makapuf/bitbox/hardware/palette_b.png

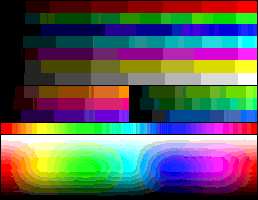
hardware/palette_b.png
