makapuf/bitbox/hardware/pal_micro.png

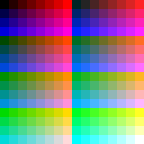
hardware/pal_micro.png
