makapuf/bitbox/README.md

bitbox
======

This is the core project for revision 2 bitbox.

Bitbox is a 32bit open hardware/source DIY console based on a unique chip (a cortex m4 with 1MB flash and 192k RAM).
It has 2 USB devices input, stereo sound output, micro SD card, VGA graphics up to 800x600 @ 32k colors. On the software side, a bootloader, simulators and several games, emulators and libraries.

Also the hardware is included here.

More info on [the development blog](http://bitboxconsole.blogspot.com)



Information can be found on [the project wiki](https://github.com/makapuf/bitbox/wiki)

You can also hop on the mailing list : bitbox-console@googlegroups.com  / https://groups.google.com/forum/#!forum/bitbox-console

Other repos
=========

This repository include the base SDK and some examples. There are other repos on github however: 

 * [A jumper game](https://github.com/makapuf/bitbox-jump)
 * [A GameBoy emulator](https://github.com/makapuf/bitboy)
 * [A ZX Spectrum 48 emulator](https://github.com/makapuf/bitbox-spectrum)
 * [Another game](https://github.com/makapuf/bitbox-polar)
 * [A sound toy / Rhythm box](https://github.com/makapuf/beatblocks)
 * [beam racer - a car game (WIP)](https://github.com/pulkomandy/beamracer_btbx)
 
... and many more ! See [the software index](https://github.com/makapuf/bitbox/wiki/Software-Index) on the wiki
makapuf
