makapuf/bitbox/hardware/README.md

hardware schematics and board licensed under the CC BY SA NC license.
please contact me for commercial uses

makapuf2@gmail.com
