makapuf/bitbox/2nd_boot/8x16_437.png

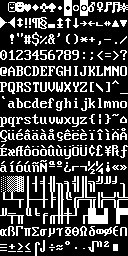
2nd_boot/8x16_437.png
