makapuf/bitbox/examples/blitter_balls/ball/0001.png

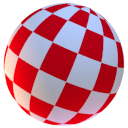
examples/blitter_balls/ball/0001.png
