makapuf/bitbox/examples/blitter_balls/ball/0002.png

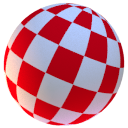
examples/blitter_balls/ball/0002.png
