makapuf/bitbox/examples/blitter_balls/ball/0003.png

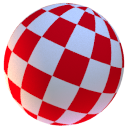
examples/blitter_balls/ball/0003.png
