makapuf/bitbox/examples/blitter_balls/ball/0004.png

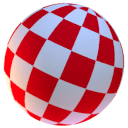
examples/blitter_balls/ball/0004.png
