makapuf/bitbox/examples/blitter_balls/ball/0005.png

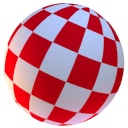
examples/blitter_balls/ball/0005.png
