makapuf/bitbox/examples/blitter_balls/ball/0006.png

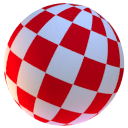
examples/blitter_balls/ball/0006.png
