makapuf/bitbox/examples/blitter_balls/ball/0007.png

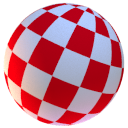
examples/blitter_balls/ball/0007.png
