makapuf/bitbox/examples/blitter_balls/ball/0008.png

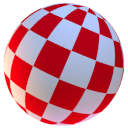
examples/blitter_balls/ball/0008.png
