makapuf/bitbox/examples/sdio/hardcore.png

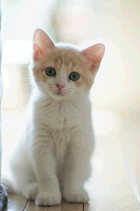
examples/sdio/hardcore.png
