makapuf/bitbox/hardware/micro r15 pcb.png

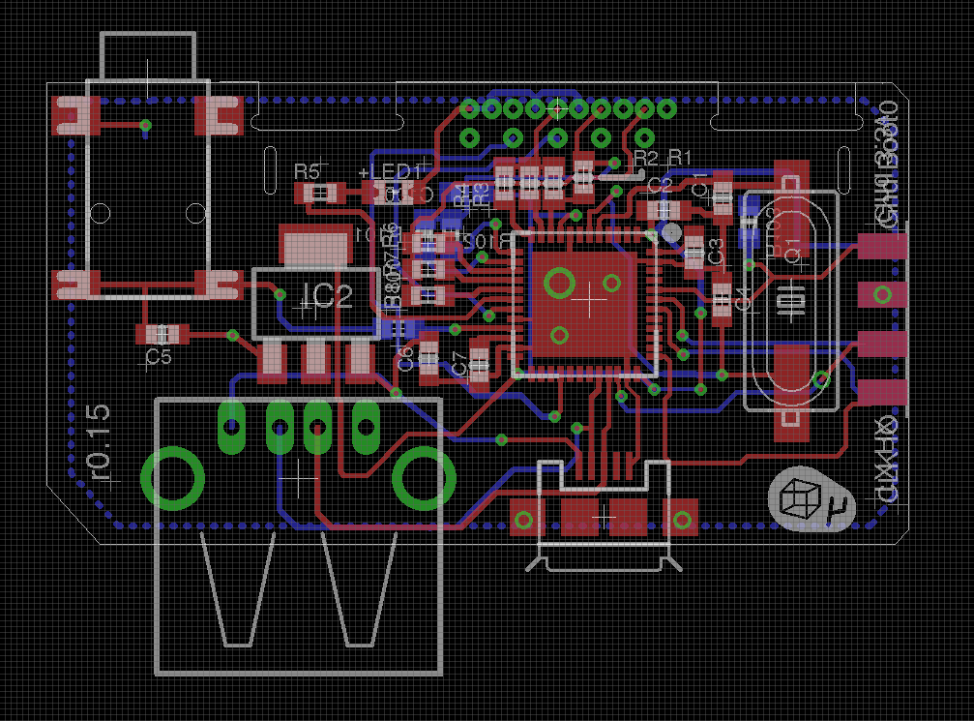
hardware/micro r15 pcb.png
