makapuf/bitbox/hardware/micro r15 sch.png

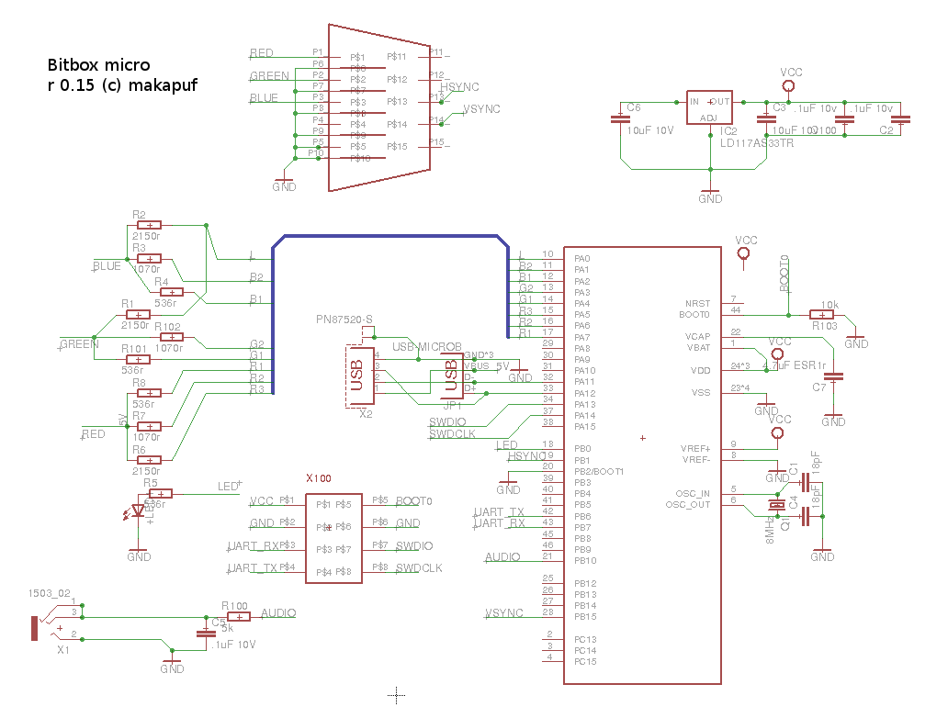
hardware/micro r15 sch.png
