makapuf/bitbox/hardware/palette_analysis.png

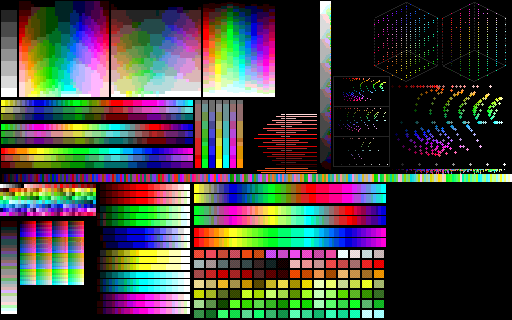
hardware/palette_analysis.png
