makapuf/bitbox/(list of files, cad)

Other CAD files:
examples/blitter_balls/amiga_ball.blend
