makapuf/bitbox/(threads)

Thread 19 (2014-11-23):

make bootloader work with one button

makapuf, 2014-11-23:
short press = next file
long press (after first release) = write it

makapuf, 2017-11-04:
was done long ago

Closed 2017-11-04.

Thread 26 (2015-02-18):

Compile with llvm ?

natir, 2015-02-18:
Hello,

I see on internet we can use llvm for cross-compile to arm-none-eabi.
I'm not sure is important but maybe llvm is better compiler, or we found some other bug with llvm. I thing have many compiler is a good think for the platform.

If you are interest I can work one patch for user can select the compiler.

makapuf, 2015-02-19:
I'm not sure at this point llvm would be a better compiler (in what metrics ? it seems gcc still has an edge for performance for baremetal). It might prove interesting to study however in the future (provided we don't complexify the build scripts for board + emulation ...). maybe trying it on a game would tell if the concept is easy. Please tell if a kernel file is not building right with llvm by example !

andybest, 2016-01-22:
I think LLVM ld still lacks good support for linker scripts, which currently stops it being useful for this sort of thing

makapuf, 2016-03-24:
thanks, will close for now

Closed 2016-03-24.

Thread 34 (2015-06-29):

add support for user options

makapuf, 2015-06-29:
user options in flash would be settable in 2nd bootloader
they will be stored in second page of flash
they can include:
keyboard type (1word)
a flag to check if data has been initialized (1word)
gamepad button mappings, default player name (1word)
maybe game specific data ? should reserve IDs in flash.

pulkomandy, 2015-07-17:
For game specific data it woudl be possible to implement a "cookie jar" system. Some inspiration: http://toshyp.atari.org/en/003007.html

makapuf, 2015-07-17:
well, I did implement a system like this, (lib/eeprom.c/h) but I never used it, too complex.

Couldn't we use a simpler system with a fixed array of u16 values in flash with identifiers set in a header in the main repo lib ?
example of a options.h file :
```
#define OPT_PACMAN_HISCORE 12
#define OPT_BITBOX_KEYBOARD 1 // useful values : 0xffff=EN, 0001 : FR, ..
#define OPT_PULKOTACKER_THEME 5
```

directly reading flash_options[OPT_SYSTEM_KEYBOARD] and set_option(OPT_SYSTEM_KB, 2) to set those ?

Or maybe I'm missing a function of cookie jars ? (we're using a fixed size here anyways)

pulkomandy, 2015-07-17:
In the cookie jar, you can allocate tags for a lot of applications, possibly more than you have bytes in the flash memory. The idea is that users will never run ALL the apps on a bitbox, so they will only have the cookies of applications they already used. And if they run out of space, user can identify each cookie and decide to keep or remove it.

However, maybe we don't have plans for that much apps on the bitbox?

makapuf, 2015-07-17:
well, it was basically the eeprom thing (that+flash wear levelling). I
don't think it will be useful before long :) 4k with u16 data is 2048 slots
! if we use 4 per prog that's 512 games. I think we're set. If a program
needs to store some fat data, just use the SD card !

2015-07-17 14:29 GMT+02:00 Adrien Destugues <notifications@github.com>:

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

makapuf, 2015-07-26:
Well, I think I forgot something: we're not rewriting flash at will, we
need to erase flash before we write it.
So the eeprom.c were made from this need: if you need to rewrite a value,
you need to load the whole sector, erase it, modify it where you want in
RAM and then rewrite it with the new value - which not fast ! So a growing
list of key/value pairs are much faster if you rewrite the same value ten
times (and wears less the flash) - like in a game when you're beating
scores repeatedly, and you can compress it from time to time.

2015-07-17 14:39 GMT+02:00 mak apuf <makapuf2@gmail.com>:

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

Thread 43 (2015-10-06):

fix tiny pixel-glitches in bitbox visual output

lowagner, 2015-10-06:
bitbox output can sometimes look clean (like when waiting for input on bootloader 2), but when activity starts or more computations are run, the output can have some small pixel glitches.

(i also added it to the [Wishlist](https://github.com/makapuf/bitbox/wiki/Wishlist)).

makapuf, 2016-09-28:
from what I can see, this happens because of interrupts having impacts on the access of buses and/or cpu states. I suggest we try outputting sound and maybe also usb during hsyncs and see what happens

pulkomandy, 2016-11-14:
On my setup this is very visible during SDCard access (for example when loading files in the chiptracker). Maybe the priority of interrupts can be tweaked and/or interrupt nesting should be enabled?

Does the SD Card and USB also use DMA or are they done with the CPU? Maybe the DMA unit does not handle well dealing with multiple channels?

makapuf, 2016-11-14:
in fact I guess the contention comes from AHB2 access during interrupts
and/or interrupts. current plans include
- polling interface through line callbacks instead of current interrupts
for sound, usb or SD
- verification of no DMA usage
- usage of sdram2 instead of SDRAM1 for blitting, CCM for sd / usb
...

2016-11-14 22:09 GMT+01:00 Adrien Destugues <notifications@github.com>:

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

lowagner, 2016-12-01:
does this have anything to do with it?
http://cliffle.com/article/2015/06/11/matrix/

lowagner, 2016-12-08:
v0.10 seems to have regressed for me, though i will try to do more testing.  at the very least, i get some black pixel rows in 16, near the center of the screen, in the main game as well as on the menus.  in the old v0.9 sdk, i wouldn't get any black lines in the menu screens, and i would only get the black lines in the main game when lots of sprites occupied the same row.

lowagner, 2016-12-08:
ok, here's the difference between old and new, 0.9 to 0.10, with the black lines:
https://www.youtube.com/watch?v=gFBTXkjD8sI

lowagner, 2016-12-10:
ok, well, things are super strange.  the other bitbox examples are fine, bdash looks good with the new v0.10 sdk.  trying to figure out what's different about 16 compared to others (it does incorporate everything, so io, music, etc. could all be to blame.)  most of the other changes in v0.10 have been usb related:
https://github.com/makapuf/bitbox/compare/v0.9...lowagner:master#files_bucket

i suppose i should raise this as a new issue on bitbox 16 (incompatibility with sdk 0.10 update???), but i'm very puzzled!

Thread 45 (2015-12-22):

new bitbox bootloader doesn't allow usb input???

lowagner, 2015-12-22:
latest bitbox bootloader (made from 2nd_boot directory) appears not to work with input.

at some point, we could also make it so that the 2nd boot loader can't flash itself.  (was trying to do this when i noticed this bug.)

makapuf, 2015-12-22:
It's in fact worse than this, the current usb stack is for whatever reason
broken ! Please stay with / download / checkout an old kernel (pre
bigbang)  to have a good version.
Le 22 déc. 2015 6:15 PM, "Lucas O. Wagner" <notifications@github.com> a
écrit :

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

makapuf, 2015-12-22:
The current status is AFAIK only the second usb works.

lowagner, 2015-12-22:
we probably should have done another bitbox release before the new stuff.
hopefully it will get all worked out soon!

lowagner, 2015-12-28:
i think i've gotten a working premicro branch, with some of my chiptune additions.
https://github.com/lowagner/bitbox/tree/premicro
most things compile and work, though bitbox-polar has its main sprite get its plus/minus/neutral frames messed up.  can't get bitbox-jumper to compile, though.  IIRC, bitbox-raycaster has some weird color issues, as does rapidball, though they are completely playable.

though i'm not sure how to do a pull request to create a new branch on the makapuf/bitbox sdk.

makapuf, 2015-12-30:
Cool ! The polar frames will be easy to solve it's in the makefile. The
rest I will try to fix it. I think we can get this commit and tag it as a
basis for a stable branch and work on a master unstable branch. Can you
tell me the sha1 of the branching point ? Thanks !
Le 28 déc. 2015 6:35 AM, "Lucas O. Wagner" <notifications@github.com> a
écrit :

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

lowagner, 2015-12-31:
here's the spot where i went back to (i think):
2c85801f04d440f1975ceeab20541637513e4fa4

if you like, you can create a branch ("premicro" or whatever you like) and rebase back to that, and i can do a pull request.

makapuf, 2016-01-01:
ok I released a v0.8 branch (as a stable kernel version pre-micro and 15khz)
How can we process from there ? Can you rebase from this and submit a pull request to this 0.8 branch ?

Closed 2016-01-10.

Thread 59 (2016-03-07):

second usb input not always working

lowagner, 2016-03-07:
your latest commit (shuffling init code) made me wonder:  if NO_USB is not defined, is it possible to wait a second or two to try and init the second usb?  i'm still not getting very consistent 2nd player in bbgunner.  i've found i can get better chances (though not perfect) if i disconnect player one, connect player two, start the bitbox, then plug in player 1.  snake gets it pretty consistently by keeping both in.

i've tried giving the bitbox a bit more power, and that doesn't seem to help.

also, for debugging and testing other usb devices, would it be possible to have test_usb have a super low level "what i'm seeing from the usb", so we can maybe debug and add other usb devices?  (i.e., before we interpret any button press as "left" or "A", just get the usb data chunks...)  if this is possible, i can submit a new issue for it...

makapuf, 2016-04-22:
USB really needs some love, I feel it's soo unnecessarily complex... for the simple use cases we have.
It would be nice starting either to look at another usb stack or simplifying it much (to be able to debug it !) but it's quite hairy and I don't know where to start .. maybe we need to do it piecewise. and, yes, a datadump would be a good starting point.

pulkomandy, 2016-04-22:
I usually find http://www.beyondlogic.org/usbnutshell/usb1.shtml quite useful on USB matters. Lots of reading, however.

makapuf, 2016-04-22:
sure, it's a great resource which I used for an intro on USB !
It also seems the usb driver has been updated, that would be a start.

2016-04-22 11:12 GMT+02:00 Adrien Destugues <notifications@github.com>:

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

lowagner, 2016-12-12:
still would love to understand why we get plug-and-unplug OK for the first player, but it doesn't really work for player two.  i like making multiplayer games for the bitbox, but it's a pain to get it setup so player 2 works!  (lots of trial and error...)

makapuf, 2016-12-12:
Yes this need some more work.

Le 13 déc. 2016 00:40, "Lucas O. Wagner" <notifications@github.com> a
écrit :

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

lowagner, 2017-07-20:
as a note, 2nd player works even less well with commit:
513c4bba001212931d3f6c4a8b1e3bfa087dd1eb

this branch reverts that and gets back to about where we were (>50% chance of 2nd player working):
https://github.com/lowagner/bitbox/tree/test

makapuf, 2017-07-26:
Hi, I tried reverting this commit and have not had much success, ie the success rate is about the same (50%).
Do you confirm it's the case with your device ?
Also, I updated the test usb to give more details , can you try it and give me the results when working or not ?
also, can you try plugging a mouse by example on the second por with test usb and tell me the results also ?
thanks

lowagner, 2017-07-26:
i seem to get much worse success than 50% with the above commit 513c4bb, and around 50% without it (when commit 513c4bb is reverted); but i will report back soon with the results from test_usb.

makapuf, 2017-09-14:
can you send me your binaries ? Maybe there is a mismatch in binary code ?

2017-07-26 15:49 GMT+02:00 Lucas O. Wagner <notifications@github.com>:

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

Thread 63 (2016-05-24):

change graph_frame to graph_line

makapuf, 2016-05-24:
The idea of this would be to replace the graph_frame callback, which happen in a line callback (so you have only one line worth of time) to calls to graph_line even during the vblank period.

The way to distinguish would be by checking that vga_line is > VGA_V_PIXELS, but this would allow spreading synchronous processing to several lines and simplify the API (one less callback). But this will be incompatible so let's wait for a new branch.

makapuf, 2016-10-01:
Done in branch 0.2

This will be done using a graph_vsync since there is no case where  vsync and display functions wont be completely different.

Closed 2016-10-01.

Thread 66 (2016-06-21):

replace graph_frame with graph_lines

makapuf, 2016-06-21:
have only one graph_line callback instead of two
It would allow better vsync lines usage since we would use all vsync lines.
This will be incompatible with current kernels, just check vga_line is < VGA_PIXEL_H for normal operation.

makapuf, 2016-07-26:
duplicate of #63

Closed 2016-07-26.

Thread 67 (2016-07-24):

need some defines for NO_VGA

lowagner, 2016-07-24:
need to add some define checking to compile with NO_VGA option, at least in these locations:

```
diff --git a/lib/emulator.c b/lib/emulator.c
index df6aaad..9b857fe 100644
--- a/lib/emulator.c
+++ b/lib/emulator.c
@@ -99,6 +99,7 @@ uint32_t time_left(void)
 }

+#ifndef NO_VGA
 extern uint16_t palette_flash[256];

 void __attribute__ ((weak, optimize("-O3"))) graph_line(void)
@@ -113,6 +114,7 @@ void __attribute__ ((weak, optimize("-O3"))) graph_line(void)
             draw_buffer[i] = palette_flash[drawbuf8[i]];
     }
 }
+#endif

 /* naive pixel conversion
 from 16bit bitbox pixel 0RRRRRGGGGGBBBBB
@@ -673,10 +675,12 @@ int main ( int argc, char** argv )
         // update time
         vga_frame++;

+        #ifndef NO_VGA
         if (scale==1)
             refresh_screen(screen);
         else
             refresh_screen2x(screen);
+        #endif

         SDL_Delay(time_left());
         next_time += slow ? TICK_INTERVAL*10:TICK_INTERVAL;
```

oh, and bitbox_main.c also requires it, since vga_frame isn't defined.
```
▸   ▸   #ifndef NO_VGA
▸   ▸   int oframe=vga_frame;
▸   ▸   while (oframe==vga_frame);
▸   ▸   #endif
```

lowagner, 2016-07-24:
here's an example project:
https://github.com/lowagner/bitbox-modes/tree/master/noisebox

lowagner, 2016-07-26:
fixed with a26ca5c6f0f45bc152ca86cad36c9373d9e4d15a

Closed 2016-07-26.

Thread 71 (2016-09-28):

refactor libraries

makapuf, 2016-09-28:
libraries should go in their own directories and maybe not in kernel.
including libs in projects would imply adding them in makefile and not declaring any makefile magick.
Also remove old chiptune code.
would then allow more libs to be distributed in main project and simplify kernel directory

makapuf, 2016-09-28:
also maybe let events be a simple library

lowagner, 2016-09-28:
just make sure to put out a metastable release before we do anything crazy...

makapuf, 2016-09-29:
sure, (well the idea is just to change a few paths and adapt slightly APIs, but the 0.1 branch will be "properly" maintained - as in, not completely forgotten)

I just now refrain from integrating interesting libs because of the current big lib directory mess (*ahem* tile16 *ahem*). splitting into useful libs + base kernel can be useful.

Also, versioning APIs and simplifying build process can be useful. not all needs to be automated by example.

Milestone 0.2 ideas welcomed ! just add issues.

makapuf, 2016-09-29:
the smaller kernel could allow inclusion in projects, *optionally* allowing it to be released as part of the game for easier compatibility breaking changes (by example using submodules).

makapuf, 2016-09-29:
namely, move :

- blitter.c, blitter.h, blitter_btc.c, blitter_sprites.c, blitter_tmap.c
- chiptune.c, chiptune.h, chiptune_engine.c, chiptune_engine.h, chiptune_player.c, chiptune_player.h
- eeprom.c, eeprom.h
- evt_queue.c /.h (in bitbox)
- sampler.c, sampler.h
- simple.c, simple.h, simple_micro.c

lowagner, 2016-09-29:
sounds good!  what were you thinking of integrating from tile 16?

so you're thinking of having separate directories for each "category" of the current libs?

makapuf, 2016-09-29:
well tile16 as a general tile/sprite engine could be useful !
I propose having one big lib dir for now, with preferably one .c and one .h per lib (with dc in .h and - maybe even one .h only) + maybe a script in /scripts (renamed /bin ?)

makapuf, 2016-09-29:
also planning to integrate misc other libs from myself : .bmp / .tar loader, ..

makapuf, 2016-10-01:
almost done for the refactoring in branch 0.2 , also modified a few libs (not much for now but work is still ongoing).

makapuf, 2016-10-06:
going further, I guess it would be nice to have a subdir of /lib for each library with
- .h/.c lib files
- test.c + Makefile of the test
- helper python scripts
- any other support files

by example :
/lib/blitter/blitter.h and lib/blitter/example.c, /lib/blitter/tmx.py
/lib/textmode/font2c.py /lib/textmode/font8x8.png, /lib/textmode/textmode.h
/lib/chip/chip.h, /lib/chip/song2c.py

using them with
#include "textmode/textmode.h"
...

any thoughts ?

lowagner, 2016-10-06:
it might help to organize things.  and when a new person comes in, they can understand what different scripts are for (at least within a category) -- which would be helpful.

makapuf, 2016-10-11:
mostly done in branch 0.2

Closed 2016-10-11.

Thread 72 (2016-10-04):

support gravis/snes controller

makapuf, 2016-10-04:
the support of those controllers could be made using a library,
- writing to the standard interface for controllers gamepad_buttons on gamepad 0
- we would need a small buffer processed at hsync time.  115200bps == 14400 Bps so we could just check every line that we need to send/receive something (avoiding interrupts). but that would need support from the kernel instead of using a library.

this could use a general async file interface with 0 as fd for uart
the async interface for read/writes could be:

    int _write (int fd, const char *ptr, int len) : async write len bytes. write len=0 to cancel writes. returns 0 ?
    int _write_busy (int fd); // return bytes left to send.

    int _read (int fd, char *ptr, int len) : async read up to len bytes to buffer. returns 0 ? error ?
    int _read_busy (int fd); // return bytes left to read

we could thus interface with a mini printf !

pulkomandy, 2016-11-14:
Example for Gravis protocol implementation: https://github.com/pulkomandy/stm32f3/blob/master/src/main.c#L80

makapuf, 2016-11-15:
I see you're using interrupts, which I'd like to avoid , so would it be possible to poll on the GPIO ? What is the data rate ?
Do you think we could use SPI to deserialize data ?

makapuf, 2016-11-15:
also, I hestitate to use as a makefile variable -DGRAVIS , an explicit lib call or a dynamic (but how would we use different hardware ?)

pulkomandy, 2016-11-15:
I think you can look at the previous commit for a polling version.
My notes about the protocol: http://pulkomandy.tk/_/_Electronique/_Gravis%20Interface%20Protocol

The data rate is about 20 to 25KHz on my controllers. SPI is possible except there is a continuous clock stream and no "chip select" so it won't detect the start and end of frames. You will need to look for the known start pattern (5 consecutive 1 bits) to resynchronize with the bitstream coming from SPI. Once synchronized, the stream has frames of 24bits so you can decode it with a fixed shift.

pulkomandy, 2016-11-15:
(and for the SNES: IIRC, it is up to us to generate the clock. This means we can be SPI master, whereas for Gravis, the controller generates the clock and we are SPI slave).

makapuf, 2016-11-15:
Yes the bitbox1 used snes, it's delightfully easy compared to usb

Le 15 nov. 2016 14:17, "Adrien Destugues" <notifications@github.com> a
écrit :

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

Thread 76 (2016-10-22):

master should become v0.10 branch

lowagner, 2016-10-22:
master should track along with development, just for ease of developing...

i suppose that means renaming the current master to v0.1, and renaming v0.2 to master.  (then splitting v0.2 off when a new version arises?)

(should v0.8 then be renamed to v0.08?)

thoughts?

makapuf, 2016-10-22:
good for me, but I didn't want master to be unusable. it's becoming to be ok, I just want to try working on usb. So it's a branch until I fix/validate 8bit behaviour/ basic libs.
Maybe we can have v0.8 still being v0.8, current being v0.9 and current v0.2 becoming v0.10 (would avoid renaming past things)

lowagner, 2016-10-22:
ok, fine by me.  i'll see how to unmerge your commit on greeble until the new kernel becomes useable...

makapuf, 2016-10-22:
On 16bit kernel it's definitely usable.

makapuf, 2016-10-22:
0.2 renamed to v0.10

makapuf, 2016-10-25:
If you're on 16bits it's OK.

Le 22 oct. 2016 19:14, "Lucas O. Wagner" <notifications@github.com> a
écrit :

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

lowagner, 2016-10-25:
do you mean the bitbox macro (as opposed to micro)?  16bit color i guess...

still would like 0.10 to become "master", so that master tracks along with development (and eventually 0.10 splits off when we complete all milestones for 0.10)...

i think you could do that by creating the 0.9 branch from master, then merging your 0.10 into master (though there may be some conflicts), and later we can split off a 0.10 when we start going beyond 0.10...

makapuf, 2016-10-27:
sure, I just would like to finalize things a bit in the next few days.
wouldn't using submodule for games be a good idea to have a fixed kernel version ?

pulkomandy, 2016-10-27:
Yes, games can import a specific version of the kernel as a submodule. I think this makes sense: any kernel update needs to be tested with each game, and when things are ok, it can be updated.

makapuf, 2016-10-30:
only issue is that the current kernel has many libraries (ok) and examples, bootloaders, scripts  ...
Should we really duplicate all of this in a /kernel subdirectory ?

lowagner, 2016-12-05:
sorry to bother, how is the micro lib coming along?  will we be able to set master->0.9, and merge 0.10 -> master soon?  or were you going to split the kernel off into its own repository (to become a submodule in other projects), and just keep examples in this repository?

makapuf, 2016-12-05:
Well, I think the interface changes are almost over.
I'm thinking about a bit more but they can be pushed to a v.11, it's not a big deal.

makapuf, 2016-12-05:
in the meantime, v0.10 is becoming default branch now.

makapuf, 2016-12-07:
Closed with commit a62946dd

pulkomandy, 2016-12-07:
It would be nice to have a "release" of 0.9 for future reference?

makapuf, 2016-12-07:
Sure, what kind of release are you thinking about ?

Closed 2016-12-07.

Thread 79 (2016-11-14):

emulate second gamepad on keyboard

makapuf, 2016-11-14:

makapuf, 2016-11-14:
using numpad + home/pgup .. ?

makapuf, 2016-12-12:
proposal : WASD (QWERTY) / ZQSD (AZERTY) + IOKL (buttons) + enter/space (pl1) + Arrows/keypad keys  (pl2) ? please vote !

pulkomandy, 2016-12-12:
My bitbox keyboard does not have a keypad. Maybe it would be better to fit everything on letters then?

makapuf, 2016-12-12:
Ah ok. Maybe we can have compile (or even run-) time keyboard switches ?
Sometime the directional keys must be on the left like a gamepad (eg mario watch )

Thread 80 (2016-12-07):

move over draw_buffer in relation to LineBuffers

lowagner, 2016-12-07:
in vga_bitbox.c, didn't we think to do something like this?

uint16_t *display_buffer = LineBuffer1 + 112; // will be sent to display
uint16_t *draw_buffer = LineBuffer2 + 112; // will be drawn (bg already drawn)

(112 = (1024 - 800)/2, with 800 being max horizontal resolution, so we get a big chunk on the left (112 pixels) and right (112 as well) that we can draw to without segfaults.)

not sure how to do this for the micro, or if that messes things up.

makapuf, 2016-12-07:
it's not that simple in fact, you need the DMA to start at a 4kB boundary in certain circumstances, so LineBuffer1+112 must be aligned at a 4kB boundary

lowagner, 2016-12-07:
ok, glad i didn't try to submit a PR with that then :).  not sure how it all works down on the lowest level, but will it be possible to do something like this?  i'd be happy with even 16 pixels on either side, 32 should be definitely enough -- i don't know if that helps to keep it simple.  112 doesn't have to be a thing...

makapuf, 2016-12-07:
please add a defect to remember doing it someday ! I guess it can be done playing with linker scripts.

makapuf, 2016-12-13:
See current investigations on how to do it - definitely not simple.
http://stackoverflow.com/questions/41122880/align-a-variable-in-memory-with-offset-from-power-of-two-in-memory

lowagner, 2016-12-13:
definitely looks tricky!  though i'd like 32 bytes (= 16 bitbox pixels) if possible...  sorry to be picky...

Thread 85 (2017-05-16):

misc. micro bugs

makapuf, 2017-05-16:
- it should be possible to power the micro from a PC. Currently the usb lines
- there should be a user button on micro
- maybe a power led ?
- there should definitely be a reset button on micro
- it should be possible to power the micro from a 5v external . currently it's only possible with a 3.3v regulated.

Thread 91 (2018-06-05):

A compatible sdk is missing, I can't figure out how to build the project.

Jubatian, 2018-06-05:
As of now a compatible SDK seems to be missing, the sdk subrepo link points to a nonexisting commit. The build generates several errors related to interface incompatibilities with the current sdk. I tried to check out earlier commits from the SDK (mostly those around 4 months before which align with the last commit of this repo), but neither seems to work, there are various incompatibilities.

How this should be built proper?

makapuf, 2018-06-07:
should be fixed now with commit 65802fae90a38297c6e9464e835bf1238e5a9bb8

Jubatian, 2018-06-08:
Thanks, from a clean clone, it builds now!

Closed 2018-06-07.

Thread 92 (2018-06-05):

What type of SD cards are supported?

Jubatian, 2018-06-05:
I was trying to run a game on the hardware. First (without much reading, I admit) I copied a .bin file onto a micro-SD I had lying around, plugged it in the Bitbox, and using an USB keyboard I assume I started it (the file's name showed in the selector, I tapped Enter). Then the screen went blank, my monitor wouldn't sync any more (the game is bitbox-jump by the way).

Then (as I couldn't get to have an image at all) I read how to reset it into the bootloader, and that the card should be containing a second boot binary. I copied that off from this repo (that builds for me) onto the card, and with that, I could successfully return to the second bootloader. However it is different, it wouldn't list any files on the card, even though I still had the game on it.

The card is an SDSC (256Mbytes), it was formatted FAT-16. After reading the Wiki, and seeing FAT-32 mentioned in it, I reformatted it, but still, the game's file wouldn't display (even though the second boot loader starts). I presently don't have any SDHC Micro cards, so I can't try what would happen with one.

For me it seems like that this second boot, compiled from the repo, doesn't support SDSC cards (or at least that seems to be the most plausible explanation to my experience), and maybe neither FAT-16, while probably the first boot does (as it apparently could load the second boot from the card).

Could this be? (The card is certainly an SDSC, I tested its protocol in another project)

Jubatian, 2018-06-08:
I confirmed this now. The 1st bootloader certainly can use my SD cards, I compiled a smaller example program into RAM (LINKER_RAM = 1 in the Makefile), and naming it 2nd_boot.bin, it loads as a 2nd bootloader proper. So I can actually mess around with the box this way! (so the 1st bootloader what I have on the BitBox apparently can use my cards) It is a rev.2.5 board.

pulkomandy, 2018-06-08:
On Fri, Jun 08, 2018 at 03:59:38PM +0000, Sandor Zsuga wrote:
> I confirmed this now. The 1st bootloader certainly can use my SD cards, I compiled a smaller example program into RAM (LINKER_RAM = 1 in the Makefile), and naming it 2nd_boot.bin, it loads as a 2nd bootloader proper. So I can actually mess around with the box this way! (so the 1st bootloader what I have on the BitBox apparently can use my cards) It is a rev.2.5 board.

I think I have a similar problem witn 2nd_boot failing to show any
files. But I'm not sure which version of it I'm using currently.

makapuf, 2018-06-08:
Hem. It seems 2nd boot needs definitely needs some love.

Jubatian, 2018-06-12:
I did some experiments on the 2nd bootloader. As far as I could track, the program dies in an infinite loop within game_init(), there within f_mount(), and there within find_volume(). That latter was too big for me for now to figure out (it is in sdk/kernel/fatfs/ff.c).

makapuf, 2018-06-13:
Fatfs is an independent library I used - it's used everywhere and I guess it runs much better than my own code, being gameinit or the fatfs to lower layers adapter.

Jubatian, 2018-06-13:
"or the fatfs to lower layer adapter" - I am also thinking that the most possible, however the way I attempted to debug it would be necessary to go through the Fatfs library until pinpointing an interface routine. I simply comment out code and look at the results, it is quite simple: if the bouncy smiley is there, then game_init() passes, if not, then it doesn't. Very tedious as for every attempt it is necessary to check it on the micro (and I have only an SD reader, not Micro-SD, and only a single monitor, so that's a lots of plugging in & out for a single test).

Jubatian, 2018-06-14:
I tracked the execution path further, finding this:

game_init() -> ff.c/f_mount() -> find_volume() -> diskio.c/disk_initialize() -> stm32f4_discovery_sdio_sd.c/SD_Init() -> SD_EnableWideBusOperation() -> SDEnWideBus(ENABLE) -> FindSCR()

There it gets stuck in the loop starting as "while(!(SDIO->STA & (...".

I have absolutely zero experience with ARM so far or these libraries, so I am passing from this. I am planning to experiment with small stuff anyway, for that, the first boot for me is OK for now.

Thread 93 (2020-05-25):

Finding the firmware files

heshananupama, 2020-05-25:
Do you have prebuilt firmware files. I tried to build the examples using examples but it end up in number of errors, I would only need the firmwares and if there are already built firmware that would be great. Thanks

pulkomandy, 2020-05-26:
SDL is not needed for the bitbox firmware. You can run 'make' in the 1st-boot folder to build the stage 1 bootloader. You can also use 'make stlink' to flash it to the bitbox using an STLink. For the other projects (2nd stage loader and examples) you can use 'make bitbox', and 'make dfu' to flash them over USB to the bitbox (much easier than putting them on an SD card to load them).

The SDL emulator currently needs SDL 1.2, which is  deprecated. They should be migrated to SDL2.

makapuf, 2020-05-27:
thanks Adrien,
indeed the version of SDL is quite dated.
I created a new branch with SDL2, but I did not port yet the main repo to it
It's a bit slow on my VM now, I'll check if it can be made faster.
In any case, it seems to work (although I diodn't test it on mac or haiku
:( )

I'ml try to make some firmware available

Le mar. 26 mai 2020 à 11:12, Adrien Destugues <notifications@github.com> a
écrit :

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
