makapuf/bitbox/hardware/microXusb401_r15.brd

## EAGLE design hardware/microXusb401_r15.brd (2016-02-25)

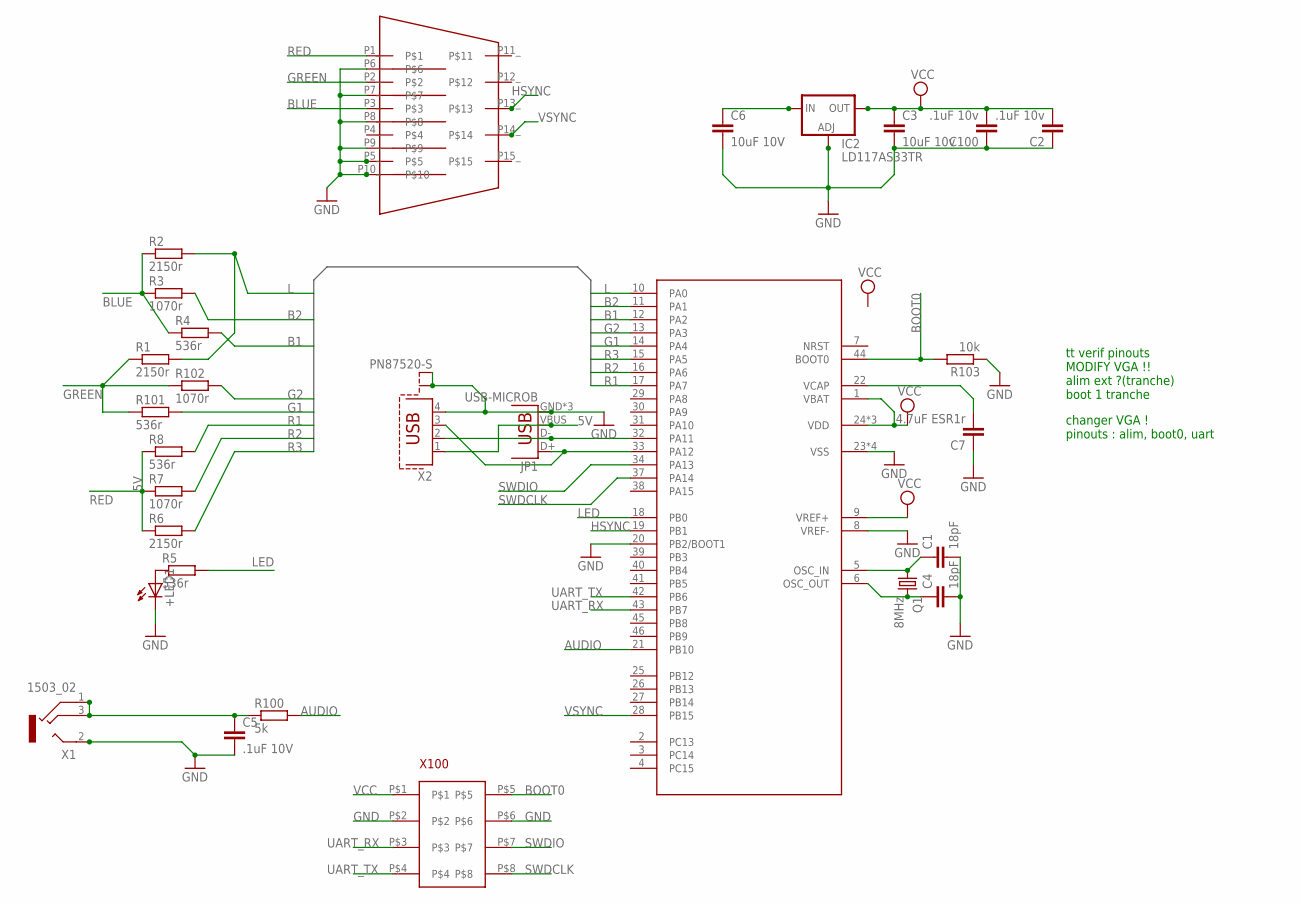
[picture p16: schematic microXusb401_r15.sch]

Parts:
+LED1: LEDCHIPLED_0805; CHIPLED_0805
C1, C4: 18pF; C1608
C2, C100: .1uF 10v; C1608
C3: 10uF 10v; C1608
C5: .1uF 10V; C1608
C6: 10uF 10V; C1608
C7: 4.7uF ESR1r; C1608
CON1: VGA_GTK_USLIM; VGA_SLIM3
IC1: STM32F401CCUQFN48_B; QFN-48
IC2: LD117AS33TR; SOT223
JP1: USB-MICROB
Q1: 8MHz; SM49
R1, R2, R6: 2150r; R0603
R3, R7, R102: 1070r; R0603
R4, R5, R8, R101: 536r; R0603
R100: 5k; R0603
R103: 10k; R0603
X1: 1503_02
X2: PN87520-S
X100: HEADER_BORDER_4X2

Connections:
5V: C6.1, IC2.3 (IN), JP1.VBUS, X2.1
AUDIO: IC1.21 (PB10), R100.2
B1: IC1.12 (PA2), R4.2
B2: IC1.11 (PA1), R3.2
BLUE: CON1.P3_, R2.1, R3.1, R4.1
BOOT0: IC1.44 (BOOT0), R103.2, X100.P$5
G1: IC1.14 (PA4), R101.2
G2: IC1.13 (PA3), R102.2
GND: +LED1.C, C1.2, C2.1, C3.2, C4.2, C5.2, C6.2, C7.1, C100.1, CON1.P5_, CON1.P6_, CON1.P7_, CON1.P8_, CON1.P9_, CON1.P10_, IC1.8 (VREF-), IC1.20 (PB2/BOOT1), IC1.23 (VSS), IC1.35 (VSS), IC1.47 (VSS), IC1.EXP (VSS), IC2.1 (ADJ), JP1.GND, JP1.MT1 (GND), JP1.MT2 (GND), R103.1, X1.2, X2.4, X2.S1, X2.S2, X100.P$2, X100.P$6
GREEN: CON1.P2_, R1.1, R101.1, R102.1
HSYNC: CON1.P13_, IC1.19 (PB1)
L: IC1.10 (PA0), R1.2, R2.2
LED: IC1.18 (PB0), R5.2
unnamed: IC1.33 (PA12), JP1.D+, X2.3
unnamed: IC1.32 (PA11), JP1.D-, X2.2
unnamed: C7.2, IC1.22 (VCAP)
unnamed: C5.1, R100.1, X1.1, X1.3
unnamed: +LED1.A, R5.1
unnamed: C1.1, IC1.5 (OSC_IN), Q1.1
unnamed: C4.1, IC1.6 (OSC_OUT), Q1.2
R1: IC1.17 (PA7), R8.2
R2: IC1.16 (PA6), R7.2
R3: IC1.15 (PA5), R6.2
RED: CON1.P1_, R6.1, R7.1, R8.1
SWDCLK: IC1.37 (PA14), X100.P$8
SWDIO: IC1.34 (PA13), X100.P$7
UART_RX: IC1.43 (PB7), X100.P$3
UART_TX: IC1.42 (PB6), X100.P$4
VCC: C2.2, C3.1, C100.2, IC1.1 (VBAT), IC1.9 (VREF+), IC1.24 (VDD), IC1.36 (VDD), IC1.48 (VDD), IC2.4 (OUT), X100.P$1
VSYNC: CON1.P14_, IC1.28 (PB15)

Notes on the sheet:
changer VGA ! pinouts : alim, boot0, uart
tt verif pinouts MODIFY VGA !! alim ext ?(tranche) boot 1 tranche

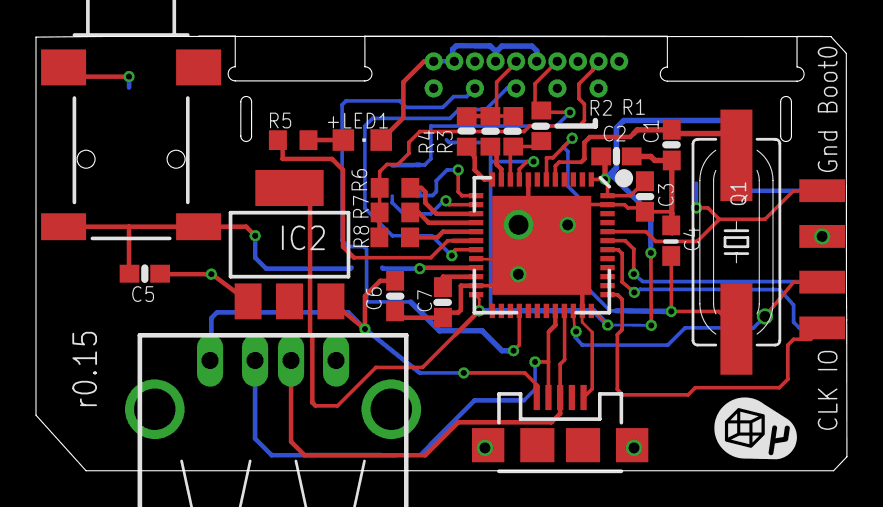
[picture p17: board microXusb401_r15.brd from above]

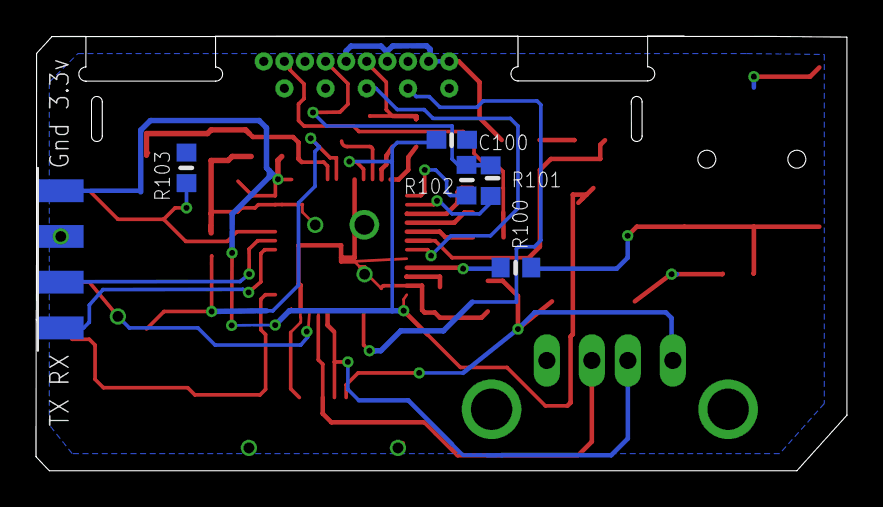
[picture p18: board microXusb401_r15.brd from below]

Board: 2 copper layers, 45.0 x 24.1 mm, 29 parts (6 on the bottom side), 30 nets.
