makapuf/bitbox/hardware/bitbox_rev2b_05.sym.brd

## EAGLE design hardware/bitbox_rev2b_05.sym.brd (2014-12-13)

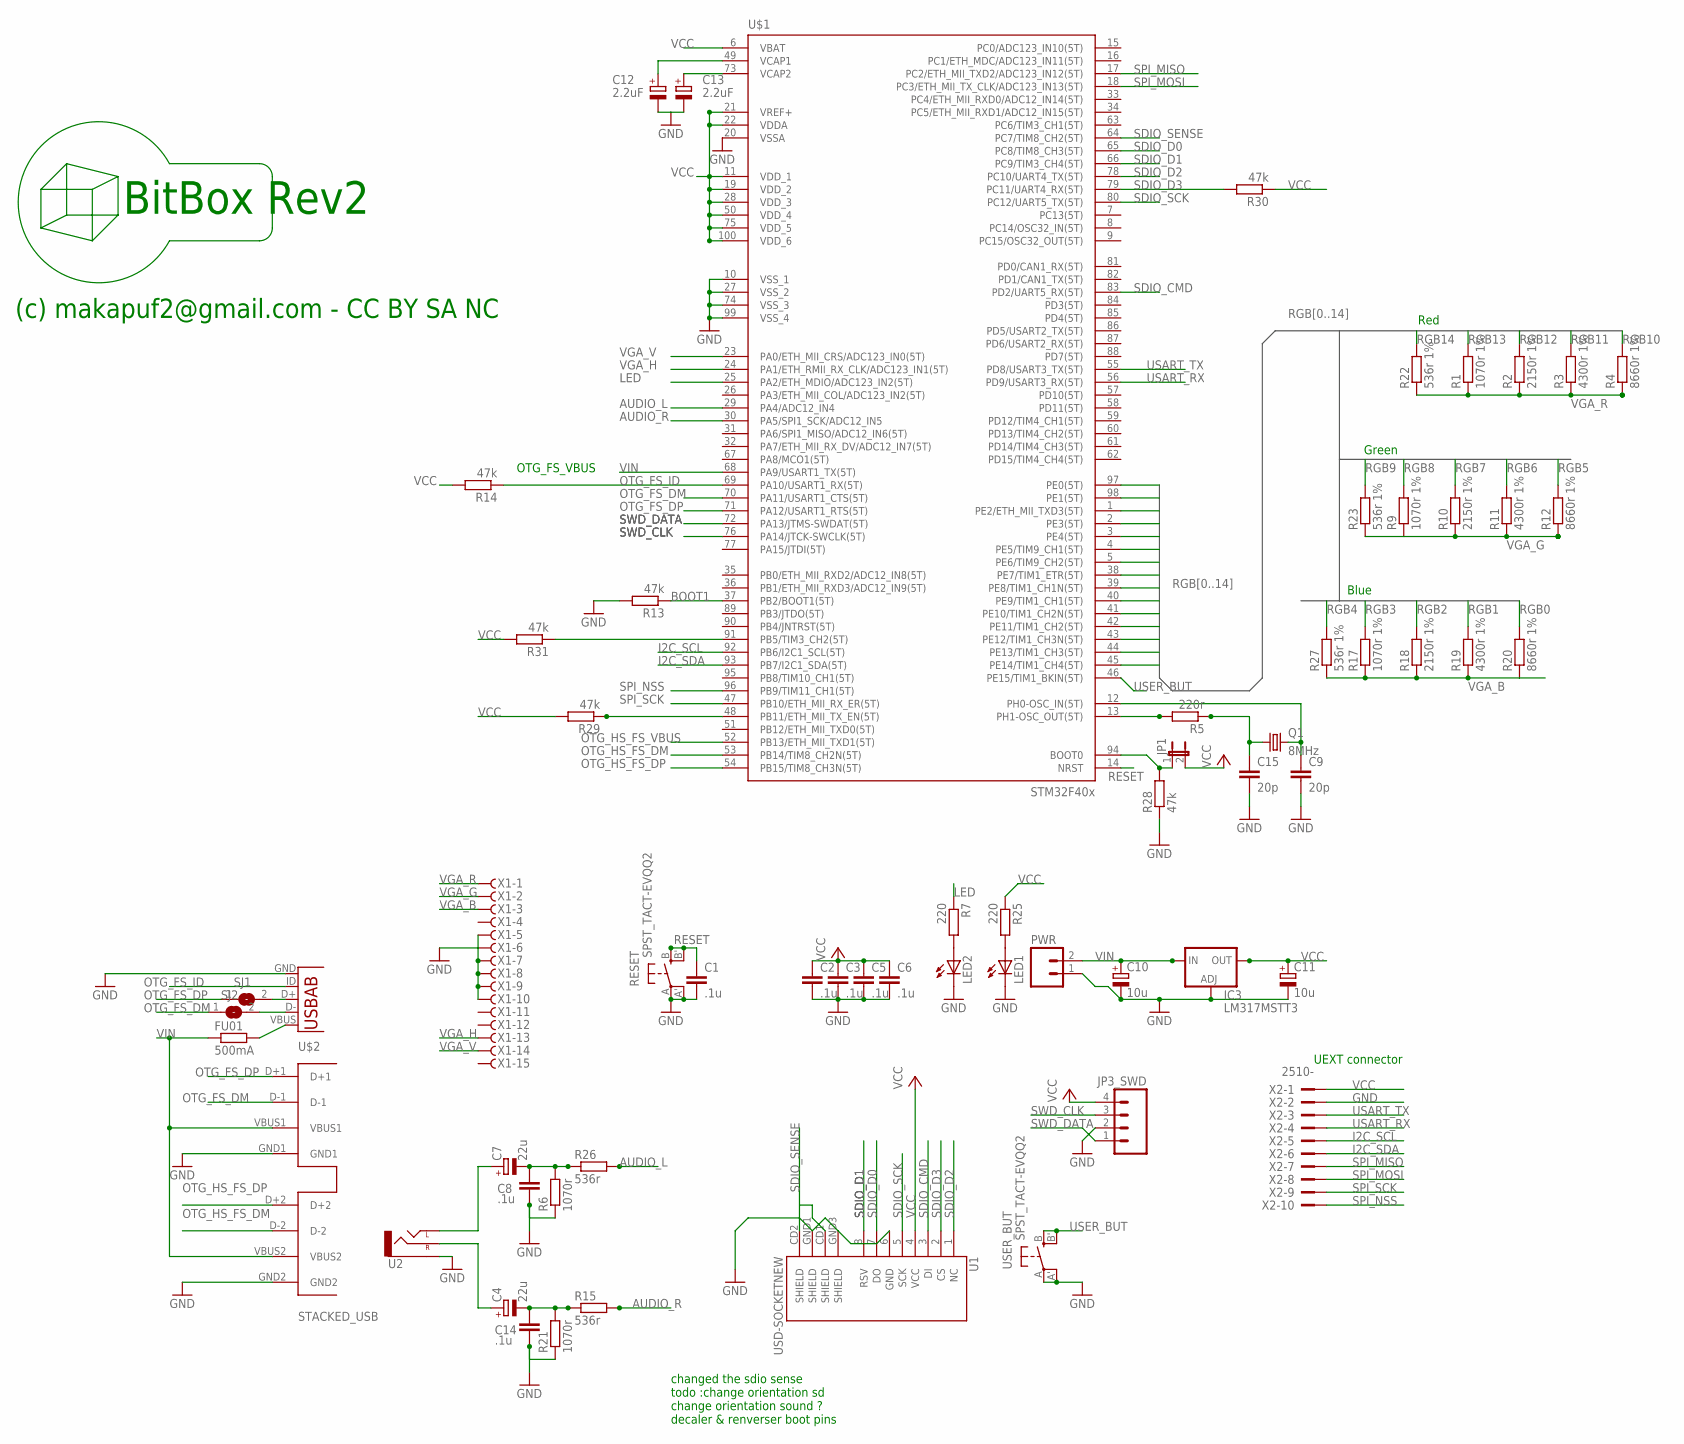
[picture p19: schematic bitbox_rev2b_05.sym.sch]

Parts:
C1, C2, C3, C5, C6, C8, C14: .1u; C0603
C4, C7: 22u; 153CLV-0505
C9, C15: 20p; C0603
C10, C11: 10u; SMC_A
C12, C13: 2.2uF; SMC_A
FU01: 500mA; R1206
IC3: LM317MSTT3; SOT223
JP1: JP1E; JP1
JP3_SWD: M04PTH; 1X04
LED1, LED2: LEDCHIPLED_0805; CHIPLED_0805
PWR: M02PTH; 1X02
Q1: 8MHz; SM49
R1, R9, R17: 1070r 1%; R0603
R2, R10, R18: 2150r 1%; R0603
R3, R11, R19: 4300r 1%; R0603
R4, R12, R20: 8660r 1%; R0603
R5: 220r; R0603
R6, R21: 1070r; R0603
R7, R25: 220; R0603
R13, R14, R28, R29, R30, R31: 47k; R0603
R15, R26: 536r; R0603
R22, R23, R27: 536r 1%; R0603
RESET: SPST_TACT-EVQQ2; EVQ-Q2
SJ1, SJ2: SJ
U1: USD-SOCKETNEW; MICRO-SD-SOCKET-PP
U2: AUDIO-JACKPTH; AUDIO-JACK
U3: USB-AB; USB-AB-MICRO-SMD
U$1: STM32F407V; TQFP100
U$2: STACKED_USB; 2STACKED
USER_BUT: SPST_TACT-EVQQ2; EVQ-Q2
X1: HF15HS; HDF15H
X2: 2510-; PAK100/2500-10

Connections:
AUDIO_L: R26.2, U$1.29 (PA4/ADC12_IN4)
AUDIO_R: R15.2, U$1.30 (PA5/SPI1_SCK/ADC12_IN5)
BOOT1: R13.1, U$1.37 (PB2/BOOT1(5T))
GND: C1.2, C2.2, C3.2, C5.2, C6.2, C8.2, C9.2, C10.-, C11.-, C12.-, C13.-, C14.2, C15.2, IC3.1 (ADJ), JP3_SWD.2, LED1.C, LED2.C, PWR.1, R6.1, R13.2, R21.1, R28.1, RESET.A, RESET.A' (P1), U1.6 (GND), U1.GND1 (SHIELD), U1.GND3 (SHIELD), U2.SLEEVE, U3.GND, U$1.10 (VSS_1), U$1.20 (VSSA), U$1.27 (VSS_2), U$1.74 (VSS_3), U$1.99 (VSS_4), U$2.GND1, U$2.GND2, USER_BUT.A, USER_BUT.A' (P1), X1.5, X1.6, X1.7, X1.8, X1.9, X1.10, X2.2
I2C_SCL: U$1.92 (PB6/I2C1_SCL(5T)), X2.5
I2C_SDA: U$1.93 (PB7/I2C1_SDA(5T)), X2.6
LED: R7.1, U$1.25 (PA2/ETH_MDIO/ADC123_IN2(5T))
unnamed: LED2.A, R7.2
unnamed: C13.+, U$1.73 (VCAP2)
unnamed: C7.+, U2.TIP (LEFT)
unnamed: C12.+, U$1.49 (VCAP1)
unnamed: SJ1.2, U3.D+
unnamed: C15.1, Q1.1, R5.1
unnamed: C9.1, Q1.2, U$1.12 (PH0-OSC_IN(5T))
unnamed: C4.-, C14.1, R15.1, R21.2
unnamed: C7.-, C8.1, R6.2, R26.1
unnamed: C4.+, U2.RING (RIGHT)
unnamed: FU01.2, U3.VBUS
unnamed: SJ2.2, U3.D-
unnamed: R31.1, U$1.91 (PB5/TIM3_CH2(5T))
unnamed: LED1.A, R25.2
unnamed: R5.2, U$1.13 (PH1-OSC_OUT(5T))
unnamed: JP1.1, R28.2, U$1.94 (BOOT0)
OTG_FS_DM: SJ2.1, U$1.70 (PA11/USART1_CTS(5T)), U$2.D-1
OTG_FS_DP: SJ1.1, U$1.71 (PA12/USART1_RTS(5T)), U$2.D+1
OTG_FS_ID: R14.1, U3.ID (USBID), U$1.69 (PA10/USART1_RX(5T))
OTG_HS_FS_DM: U$1.53 (PB14/TIM8_CH2N(5T)), U$2.D-2
OTG_HS_FS_DP: U$1.54 (PB15/TIM8_CH3N(5T)), U$2.D+2
OTG_HS_FS_VBUS: U$1.52 (PB13/ETH_MII_TXD1(5T))
RESET: C1.1, RESET.B (S), RESET.B' (S1), U$1.14 (NRST)
RGB0: R20.2, U$1.97 (PE0(5T))
RGB1: R19.2, U$1.98 (PE1(5T))
RGB2: R18.2, U$1.1 (PE2/ETH_MII_TXD3(5T))
RGB3: R17.2, U$1.2 (PE3(5T))
RGB4: R27.2, U$1.3 (PE4(5T))
RGB5: R12.2, U$1.4 (PE5/TIM9_CH1(5T))
RGB6: R11.2, U$1.5 (PE6/TIM9_CH2(5T))
RGB7: R10.2, U$1.38 (PE7/TIM1_ETR(5T))
RGB8: R9.2, U$1.39 (PE8/TIM1_CH1N(5T))
RGB9: R23.2, U$1.40 (PE9/TIM1_CH1(5T))
RGB10: R4.2, U$1.41 (PE10/TIM1_CH2N(5T))
RGB11: R3.2, U$1.42 (PE11/TIM1_CH2(5T))
RGB12: R2.2, U$1.43 (PE12/TIM1_CH3N(5T))
RGB13: R1.2, U$1.44 (PE13/TIM1_CH3(5T))
RGB14: R22.2, U$1.45 (PE14/TIM1_CH4(5T))
SDIO_CMD: U1.3 (DI), U$1.83 (PD2/UART5_RX(5T))
SDIO_D0: U1.7 (DO), U$1.65 (PC8/TIM8_CH3(5T))
SDIO_D1: U1.8 (RSV), U$1.66 (PC9/TIM3_CH4(5T))
SDIO_D2: U1.1 (NC), U$1.78 (PC10/UART4_TX(5T))
SDIO_D3: R30.2, U1.2 (CS), U$1.79 (PC11/UART4_RX(5T))
SDIO_SCK: U1.5 (SCK), U$1.80 (PC12/UART5_TX(5T))
SDIO_SENSE: U1.CD1 (SHIELD), U1.CD2 (SHIELD), U$1.64 (PC7/TIM8_CH2(5T))
SPI_MISO: U$1.17 (PC2/ETH_MII_TXD2/ADC123_IN12(5T)), X2.7
SPI_MOSI: U$1.18 (PC3/ETH_MII_TX_CLK/ADC123_IN13(5T)), X2.8
SPI_NSS: U$1.96 (PB9/TIM11_CH1(5T)), X2.10
SPI_SCK: U$1.47 (PB10/ETH_MII_RX_ER(5T)), X2.9
SWD_CLK: JP3_SWD.3, U$1.76 (PA14/JTCK-SWCLK(5T))
SWD_DATA: JP3_SWD.1, U$1.72 (PA13/JTMS-SWDAT(5T))
USART_RX: U$1.56 (PD9/USART3_RX(5T)), X2.4
USART_TX: U$1.55 (PD8/USART3_TX(5T)), X2.3
USER_BUT: U$1.46 (PE15/TIM1_BKIN(5T)), USER_BUT.B (S), USER_BUT.B' (S1)
VCC: C2.1, C3.1, C5.1, C6.1, C11.+, IC3.4 (OUT), JP1.2, JP3_SWD.4, R14.2, R25.1, R29.2, R30.1, R31.2, U1.4 (VCC), U$1.6 (VBAT), U$1.11 (VDD_1), U$1.19 (VDD_2), U$1.21 (VREF+), U$1.22 (VDDA), U$1.28 (VDD_3), U$1.50 (VDD_4), U$1.75 (VDD_5), U$1.100 (VDD_6), X2.1
VGA_B: R17.1, R18.1, R19.1, R20.1, R27.1, X1.3
VGA_G: R9.1, R10.1, R11.1, R12.1, R23.1, X1.2
VGA_H: U$1.24 (PA1/ETH_RMII_RX_CLK/ADC123_IN1(5T)), X1.13
VGA_R: R1.1, R2.1, R3.1, R4.1, R22.1, X1.1
VGA_V: U$1.23 (PA0/ETH_MII_CRS/ADC123_IN0(5T)), X1.14
VIN: C10.+, FU01.1, IC3.3 (IN), PWR.2, U$1.68 (PA9/USART1_TX(5T)), U$2.VBUS1, U$2.VBUS2
YYY: R29.1, U$1.48 (PB11/ETH_MII_TX_EN(5T))

Notes on the sheet:
Red
Green
Blue
UEXT connector
OTG_FS_VBUS
BitBox Rev2
(c) makapuf2@gmail.com - CC BY SA NC
changed the sdio sense todo :change orientation sd change orientation sound ? decaler & renverser boot pins

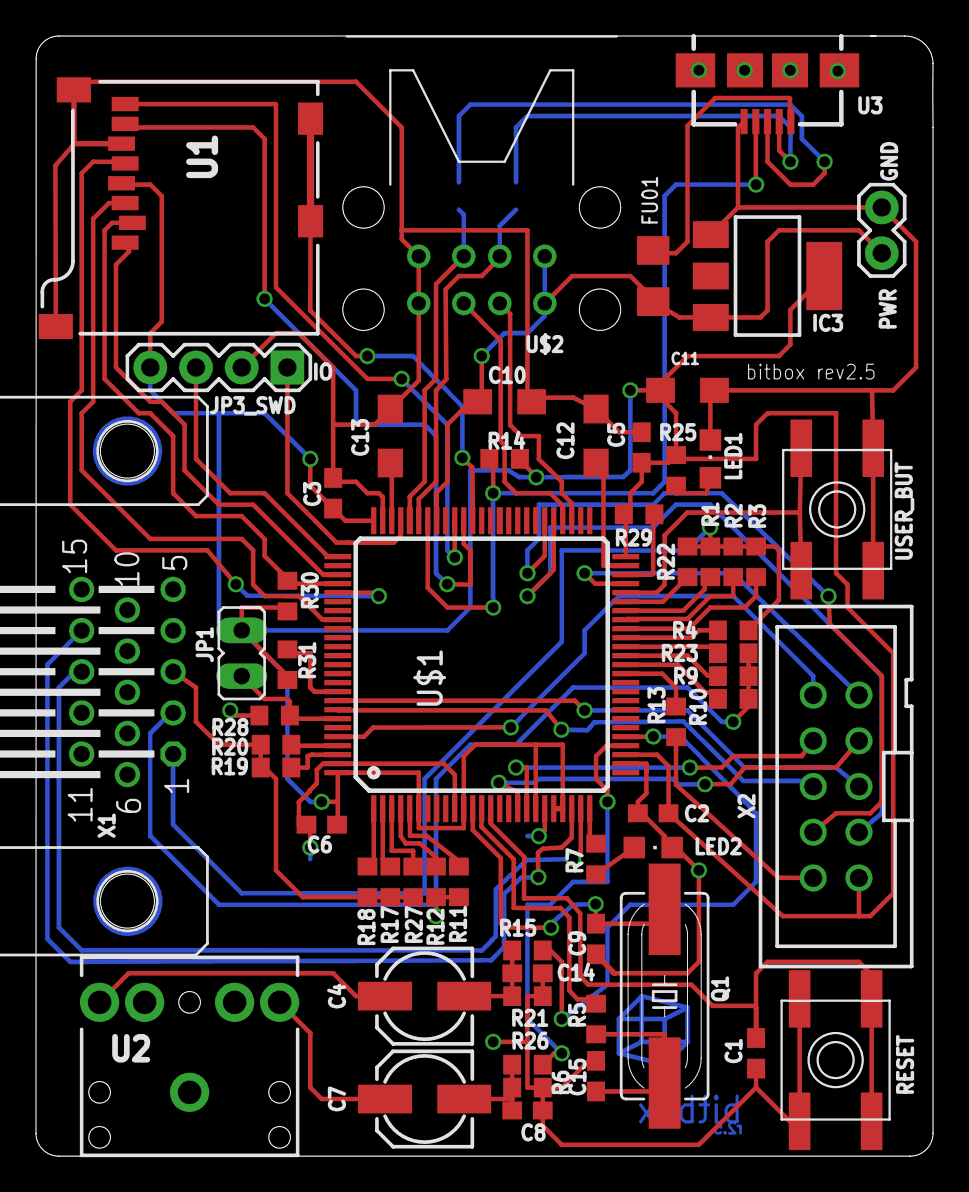
[picture p20: board bitbox_rev2b_05.sym.brd from above]

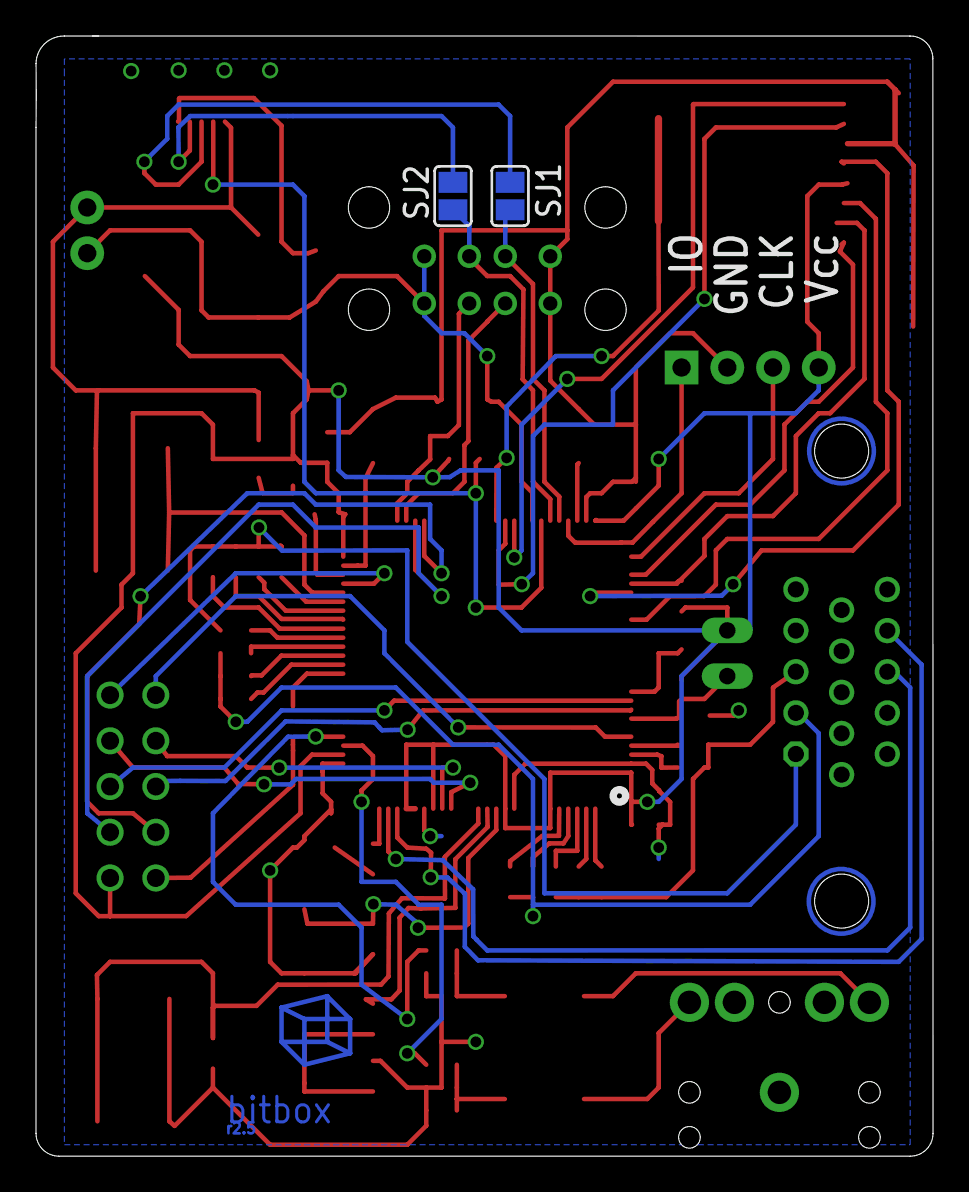
[picture p21: board bitbox_rev2b_05.sym.brd from below]

Board: 2 copper layers, 49.8 x 62.2 mm, 62 parts (2 on the bottom side), 68 nets.
