makapuf/bitbox/(commit log)

2013-10-28 first rev2 checkout !
    [bitbox_rev2_06.sym.brd, bitbox_rev2_06.sym.sch]
2013-11-07 updated board, added component values
    [bitbox_rev2_06.sym.brd, bitbox_rev2_06.sym.sch]
2013-12-01 USB support for stm32f4 discovery board
2014-01-13 added some draft bootloader and drawing library. the bootloader doesn't work at all and doen't have anyhting running, it's just ideas
    [1st_boot.c, diskio.c, ffconf.h, main.c, stm32fxxx_it.c, stm32fxxx_it.h]
2014-02-10 Changes to bitbox kernel to handle bitbox rev2 real hardware (video, user led, USB joystick) Added dual analog3 joystick tables
2014-02-12 simple LED / button handling, kernel debug
2014-02-17 Made the example finally work. Had to include a bit more STM lib than wanted (cleanup will be needed) removed tinfl, which wont be used (at least there) had to change linker script to make it work (S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
    [diskio.c, ffconf.h, main.c, startup.c, stm32fxxx_it.c, stm32fxxx_it.h]
2014-02-19 added system.c to replace st example with bitbox
    [system.c, system.h]
2014-02-23 replaced startup files with bitbox own
    [main.c]
2014-05-05 Made 2-stage boot work.
    - 1st stage (to be flashed at boot) finds 2nd stage bootloader, named 2nb_boot.bin, on the microSD card, loads it from RAM and runs it.
    Error checks are flashed on the LED
    - 2nd stage bootloader is just a blink for now, needs to be linked to SRAM2
    see memories spreadsheet to better understand what happens.
    [1st_boot.c, diskio.c, ffconf.h, startup.c, stm32fxxx_it.c, stm32fxxx_it.h, system.c]
2014-05-05 small error on the 1st bootloader
    [1st_boot.c]
2014-05-06 Added textmode for level2 boot. Currently does not handle very well exec from RAM, but works great from flash. Runs from uSD with 1st bootloader however !
2014-05-20 modifications on kernel, added encoder, modified blitter (simple)
2014-06-23 nicer selection screen with customizable BG gradient added asynchronous flasher routines in sync with (not enabled) starting icon loading "Fixed" (it's still a hack) a bug where int vector was in fla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
2014-07-02 made so that 1st boot jumps to flash if button not pressed, ie bootloader activates with button pressed when reset
    [1st_boot.c, ffconf.h]
2014-07-02 modified 2nd stage bootloader : - can effectlively flash to chip the selected file (asynchronous flash writng / file reading from microsd / erasing to let the video frames be displayed smoothly and p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
    [stm32fxxx_it.c, stm32fxxx_it.h, system.c, system.h]
2014-07-04 moved files to lib and made lib a subdirectory of projects.
    This will allow any project to be hosted separately (just make a
    submodule to track kernels)
    use symlinks to link the lib.
2014-07-12 2ndboot.c : removed last blocking bug ! the button callback did not check that a write was ongoing, so the file was reopened while being written, causing rewriting of the beginning of the file to the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
    audio.h : fixed strange noise (off by one buffer size)
    flashit.c : a few error checks, comments
    linker_loader.ld : discarded some extra stack unwinding attributes, dont know why they were there
    bitbox.h : removed reference to audio_frame which should be private
    bitbox_main : added the extern here
    bitbox.mk : added a linker_raw reference
    test_kernel : simplified a reference
    encode_anim: removed
    [main.c]
2014-07-16 bitbox.mk : re added missing dependency on data files blitter.c/h : corrected bug when y was <0 improved p16 sprites blitting (not finished) added tileset blitting (not finished ! many modes missing 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
    [main.c]
2014-07-20 Audio modifications, Audio improvements,
    Audio could not access anything in hsync irq, was put in normal thread.
    also introduced double buffering. The real fix would be to put it in a
    real double buffer DMA to Audio DACs.
    bitbox.h : modified message(...) to behave like printf (also in emu)
    bitbox.mk : parametrized start flash so that make stflash works with a bootloader
    blitter : improved a little 16x16 blitter doc in .h
    emulator : implemented chdir.
    ffconf.h : was too restrictive (also meddled with interger types)
    [main.c]
2014-08-28 added new gamepads : ps3 and thrustmaster T wireless (untested)
2014-08-28 only try to mount the microSD when button is pressed
2014-10-07 improve p4 (16colors sprite) blitter, encoder and demo
    improve python encoder to allow animated sprites
2014-10-07 *Add icons and filter bootloader files to .bin only
2014-10-30 reworked engine and graphical kernel to remove engine frame from main frame thread
2014-11-11 modify test engine with smaller sprites
    [amiga_ball.blend]
2014-11-11 add simple modes
    simple modes are modes based on a 64k framebuffer
    - text modes 80x25 132x75 characters
    - graphical modes : 800x600, 640x400, 320x240, 320x200, with different
    color depths
    - includes a demo of text modes and graphical modes
2014-11-20 Parsed HID devices
    There is an initial HID report descriptor parser in the kernel now.
    It's very simple & only handles gamepads (kb & mouse still supported via
    boot protocol)
    That means you should be able to have some functionnality out of a
    gamepad without having it supported in the kernel ! (if planets are
    fully aligned).
    There might be bugs, but you can see my gamepad is not in the tables
    anymore, since it's automatically parsed (incl analog, hat & buttons !)
    There might need a buttons remapping app to be more useable (no gamepad
    works the same) but that's a start !
    Please report non or weird functioning gamepads - note that we
    use the parsed descriptor only if it's not in the table,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
    [main.c]
2014-11-21 implement simple sampler
    Simple sampler to use in games. This is basic since the test_sampler
    does not use SDcard (to be tested & implemented).
2014-11-21 rework device input in emulator
    - added event handling as an engine (since it's on top of the kernel)
    - added events for keyboard (keycodes to be tested), mouse
    - added handling of mouse_data (buttons & co)
    - added proper joystick/gamepad handling
    - game pad emulation is done in games via evt_ functions, not in
    emulator level
2014-11-21 2D version of the text buffer
    fixed the size as well, it's now 80x30
    added print_at and simple text window drawing functions
2014-11-22 print_at: don't copy NULL char at end of string
2014-11-24 added 320x240 and 400x300 kernel modes
    These modes are a little special : only switch buffer every other line
    look for vga_odd for an odd line, youe vga_line will be called once
    with it false and one with it true for each line.
    - add them in kconf
    - update simple modes to use them
    - update simple engine to use them
    - update emulator for it (issues fake lines)
    /!\ still an issue : spreading the engine load in two lines does not
    work yet.
    [main.c]
2014-11-27 added support for hard floating point operations
    this was useful : http://www.triplespark.net/elec/pdev/arm/stm32.html
2014-11-28 beamracer: adjust for 320x240 video mode.
    Works again, but the rotation and alitudes need tweaking. Currently it
    looks a bit HYPERSPACE!
2014-12-06 Add a port of LFT's "Hardware Chiptune" player.
    * The engine.c/h files are designed to be reusable as a simple sound
    engine. This one should be small and light and not waste all your CPU
    cycles in fancy filters, mixing and other complex effects.
2014-12-07 hwchip: some fixes.
    * Wrong mixing of channels (oops)
    * Allow to loop the song
    * Remove silly "lights" stuff now that it works.
    [main.c]
2014-12-07 Optimize and cleanup
    * Move player to its own file so it is easier to reuse in other projects
    * Add some static and inlines to help the compiler optimize stuff
    * Replace the music since the original one from LFT doesn't work well
    with the modified replay rate. Enjoy the original Boulder Dash music!
    (on 3 channels only - 4th is free for sound effects!)
    [main.c]
2014-12-09 Fix test_kernel to support keyboard emulation
    [main.c]
2014-12-13 updated hardware eagle files to version 2.5 (also called 2b)
    [bitbox_rev2b_05.sym.brd, bitbox_rev2b_05.sym.sch]
2015-01-03 Make sound run on its own DMA
    from now on, sound will run at its own DMA and will not be shared with
    Video DAC. That means that sampling frequency is not linked anymore to
    vsync, (and will not change with it !) and can be anywhere from 1kHz to
    whatever the DAC can produce.
    Also, you can block in audio callback and not perturb video out (but
    don't).
    Tested on real hardware and with hwchip and test_sampler (will need to
    update a few other progs), generally nothing to do besides removing
    audio_on which does nothing now.
2015-01-05 include resampling sampler (API change !)
    Includes (bad quality ? ) resampler. This quality will probably need to
    be imporved, maybe by adding 12bits audio out or mu law samples, and
    linear interpolation, as well as better algos. Oh, well.
    Import midi & play song
    Remade sampler demo
2015-01-23 bug in parsing, change default buttons
2015-05-07 USB handlers as callbacks, main is now user-definable
    Put USB callbacks in a timer interrupt, called squarely at 125 Hz, to
    decorrelate timings from game frame (so frames can be longer without
    desyncing USB)
    Put all initialization of vga, board, audio in startup to remove from
    bitbox_main.c
    As a result, main is now a *weak symbol*, so YOU CAN REDEFINE IT
    completely (bitbox_main.c is now very small (only has this weak
    function) and might also be removed from build in the future ..)
2015-05-13 emulator did not implement User Button. Now mapped onPause key
2015-05-27 allows writing in emulator (first implementation) + update example with writing
    The implementation can have some differences when file doesn't exist and
    it's opened in exclusive write, etc etc...
    but it's globally working.
    Example writes / increment a simple hello.txt file
    [main.c]
2015-06-10 make sprite encoder order arguments
    if provided with several input files, order them
2015-06-29 implemented symbolic keyboard events
    Now kbd events have the sym field with an ascii letter representation
    of the pressed keyboard, mapped to the current keyboard layout.
    For now, the keyboard layout is a compile-time def (EN - default, FR
    option)
    It Should be put in flash config - but that would need flash config.
2015-06-29 added option to disable ESC key in emulator
2015-08-24 allow keyboard input to crappy bird, also detect any gamepad button
2015-08-27 fixed bug : button was active 0, released 1 ; inversed now
2015-09-22 allows configurable samplerate
2015-09-24 fixed track name non-valid identifiers
2015-09-29 fixed simple modes rendering
    Simple modes was not displayed on device.
    That was caused by 2 things in fact :
    - ccm memory cannot be initialized by placing data in data segment
    (since, duh, it's in CCM segment)
    - high pixel/low colors modes rendering speed was abysmal. fixed this by
    putting couples in a couple palette, replacing jumps with lookups. much
    faster.
    Tested with modes 2 to 5 ond device. not everything can be caught with
    travis & emulation ;)
2015-09-29 moved empty graph frame to engine to be available in emulator also.
2015-11-26 improved bitbox.mk
    Modularized the bitbox.mk
    now sdl has a real build environment instead of cramming
    everything in a line, test also and we will be able to add oter targets
    all is still done out of tree, in build/bitbox build/sdl and build/test
    current projects should build the same.
2015-11-27 separate kconf for kernel interface and for board
    preparing micro
2015-11-27 cleaned USB
    removed unused files / redundant files from usb drivers
    all drivers are now in usb_bsp.c which has been greatly updated /
    cleaned.
2015-11-30 use timer4 for usb since timer7 does not exist on micro
2015-12-01 move clock setup to board.c
2015-12-01 update emulator
    adds microkernel, no_audio, LED indicator
2015-12-01 use flash / non dynamic VGA Interrupts
2015-12-14 change test_sdio image name
    image.bin to image.raw (to avoid clash with executable binaries)
    [encode_image.py, main.c]
2015-12-14 adapt new_vga to new stm32f4xx version
    using again BSSRL and H
2015-12-14 allows analog buttons for both joysticks on emu
2016-01-03 exported frames should be based from local ids
2016-01-10 Fix USB HS bug
    This was due to setting wrong Alternate Function ID ! (Datasheet
    STM32F405 p62).
    Fixes #45
2016-01-11 moved VSYNC defs into board specific confs
2016-01-12 Fix out-of-screen print on PAL target
2016-01-28 bug : changed frame twice on double line modes
2016-02-25 add bitbox micro eagle files
    [microXusb401_r15.brd, microXusb401_r15.sch]
2016-03-04 fixed LED on micro
2016-03-07 use generic stm32f40_41 header
2016-05-10 add audio to bitbox micro
    There still might be one or two off-by-one errors on the buffer
    sizes but this is currently working.
    Audio on the bitbox micro is currently generated in HSYNC.
    Note that stereo buffer is still generated by the engines, but not
    played by the system.
    [main.c]
2016-06-18 updated simple modes
    implemented mode 13 for micro, also updated sample
2016-06-21 finally fixing bug #21 !
    this was due to sending DMA while still on "old" pixel line, fixed for
    bitbox and micro.
2016-07-28 Update .travis.yml
    removed (at least temporarily) the use of arm official arm gcc (t guo ppa)
2016-09-23 fix mouse buttons
2016-09-23 test led now also tests button !
2016-09-30 adds pbc format (packbit couples)
2016-09-30 tmx2 adds packbits couple ..
2016-10-01 next updates to kernel, graph_frame -> graph_vsync
    [amiga_ball.blend]
2016-10-06 adds serial input/output (also emulated on stdout)
    will include buffers and async IOs
    should this be on kernel and allow message("xxx") to print to stdout
    anyway ?
2016-11-02 Adapt framebuffer library to 8bit kernels
2016-11-02 missing include in framebuffer.h
2016-11-11 print_at: return number of printed chars
    print_at knows the number of printed char, and this can save a call to
    strlen. Part of my work to optimize screen redraw in the chiptracker.
2016-11-14 add return value to print_at (port from mainline)
2016-11-26 adds button operation for 2nd bootloader
2016-12-06 removed device .h files, removed usb otg checks
2017-01-22 chiptune: fix generation of tracks.
    Tracks may not be shorter than tracklen, otherwise the player will
    happily play the data from the next track.
    Now that this is fixed and the player does the right thing, use the
    test2 song to give a decent demo of the chiptune engine features.
2017-02-06 simplified makefiles, now needs submakes for making games
    This cleans the makefile greatly by splitting them between arm and posix
    compilations.
    For now the "old" bitbox.mk is kept but will eventually be discarded -
    or maybe kept as a compatibility stub then discarded.
2017-02-17 audio fix for when desired.samples is not correct
2017-02-19 fix sampler makefile
2017-02-19 adds lto to bitbox arm compilation flags
2017-03-13 die immediately when no more space in blitter
2017-03-26 allow definition of main as bitbox_main even in SDL
    main - now bitbox_main() is now a weak symbol everywhere.
    you can redefine it in sdl also.
    SDL now has its own separate thread for screen and gamepad updates
    running separately.
    just define it and call wait_vsync(), no need to divide your game
    between game_frame and grame_init - bitbox_main still exists and allows
    this.
2017-05-14 emulate hat for analog only on SDL
    can emulate hat if gamepad only has analog buttons (which could be a hat
    in fact) on SDL backend / emulator.
2017-05-18 updated crappy
    dithered gradient BG
    allow mouse buttons
    remove NOSDIO since it's now off by default
2017-05-20 Emulator: Fix enumerating the current directory as "".
    Chiptracker does this, and it works on real hardware.
    Replace it with "." in the emulator context.
2017-05-21 updates testusb view of device status
2017-09-01 allow redefine sample rate / audio parameters in emu conf
2017-10-12 make 2ndboot stop when flashed (flash with button)
2017-11-03 off by one in sampler
2017-11-03 removed SDK from this branch, use submodule
    [amiga_ball.blend]
